dirtdigger/fleur_de_cali/img/120x3.jpg

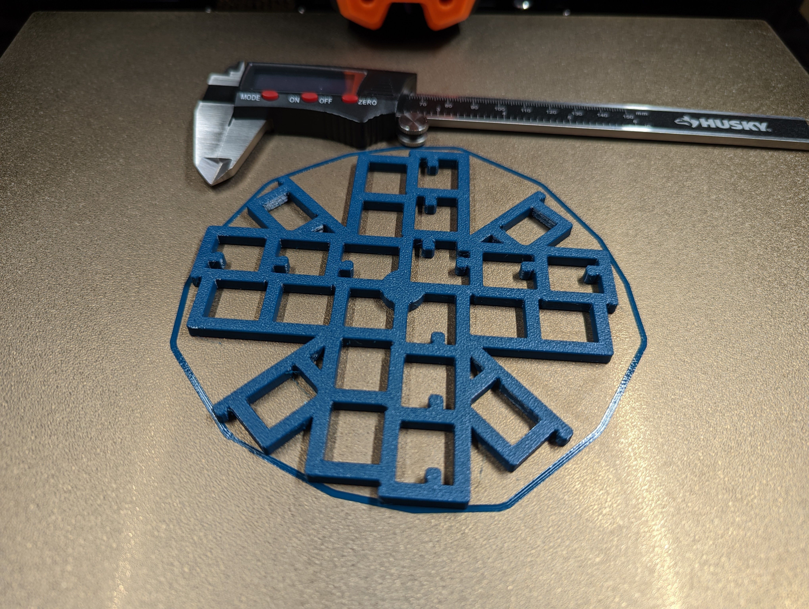
img/120x3.jpg
