dirtdigger/fleur_de_cali/img/120_D1.png

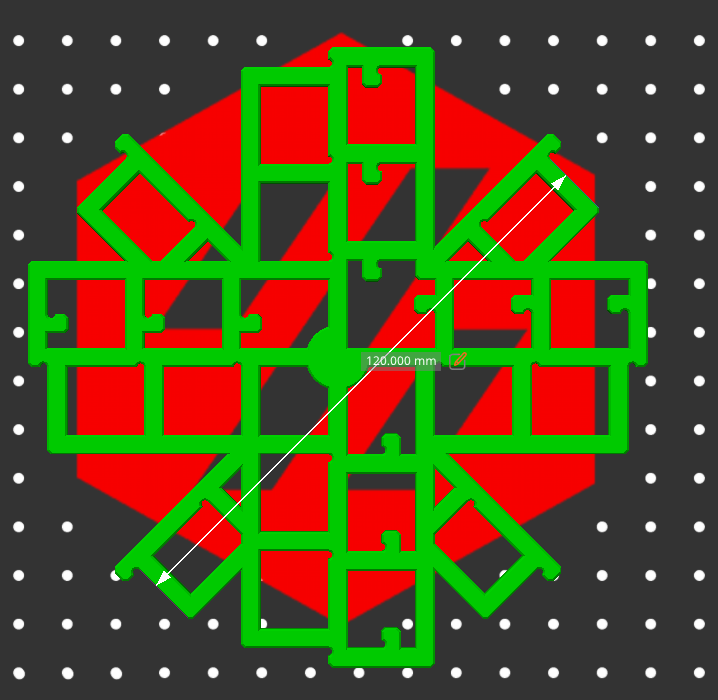
img/120_D1.png
