dirtdigger/fleur_de_cali/img/120_d1.png

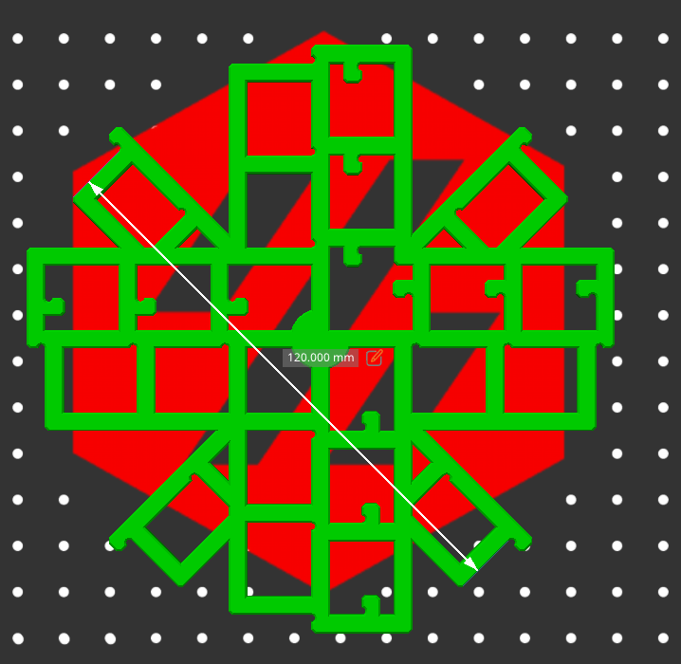
img/120_d1.png
