dirtdigger/fleur_de_cali/step/calistar_180x4.step

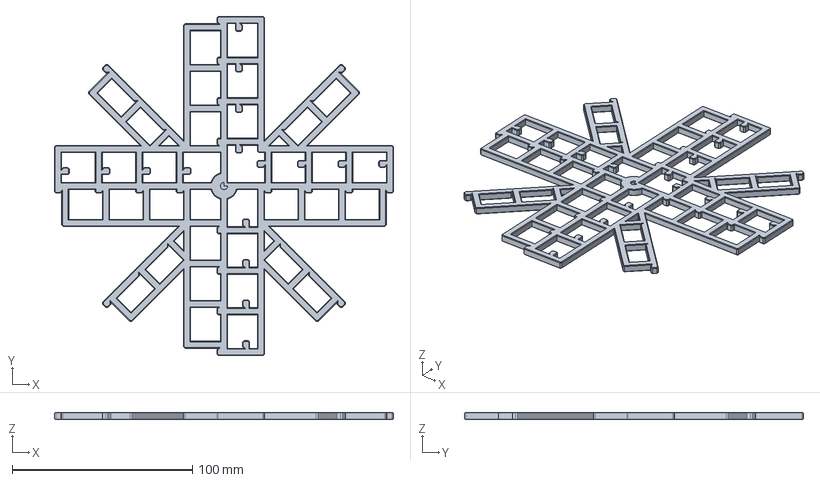
[picture p5: CAD file, 2024-03-23]
step/calistar_180x4.step
188.0 x 188.0 x 4.00 mm
