dirtdigger/fleur_de_cali/step/calistar_140x4.step

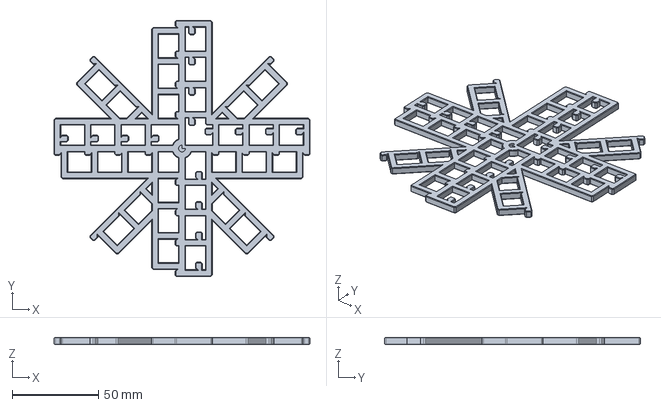
[picture p7: CAD file, 2024-03-23]
step/calistar_140x4.step
148.0 x 148.0 x 4.00 mm
