dirtdigger/fleur_de_cali/step/calistar_80x2.step

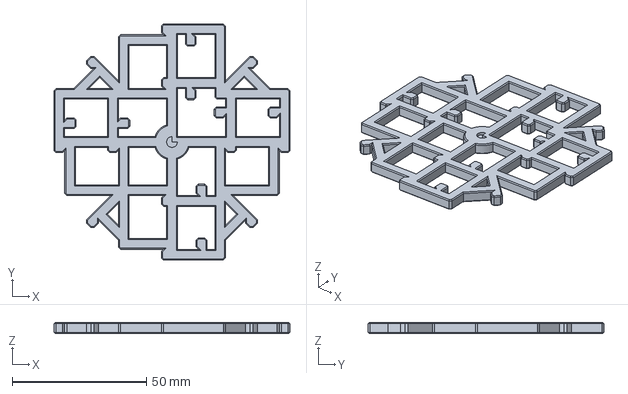
[picture p8: CAD file, 2024-03-23]
step/calistar_80x2.step
88.0 x 88.0 x 4.00 mm
