dirtdigger/fleur_de_cali/step/calistar_120x2.step

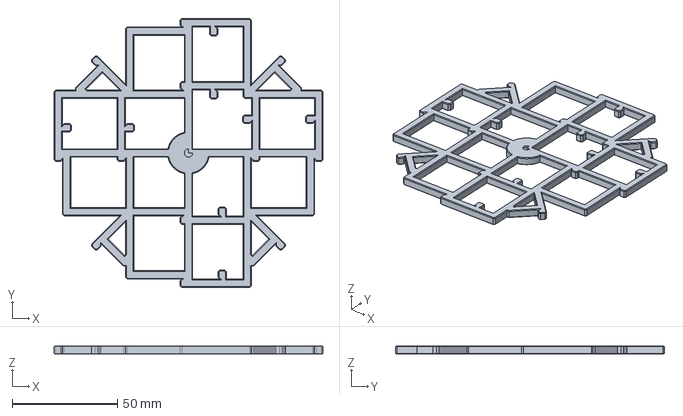
[picture p9: CAD file, 2024-03-23]
step/calistar_120x2.step
128.0 x 128.0 x 4.00 mm
