dirtdigger/fleur_de_cali/step/calistar_100x2.step

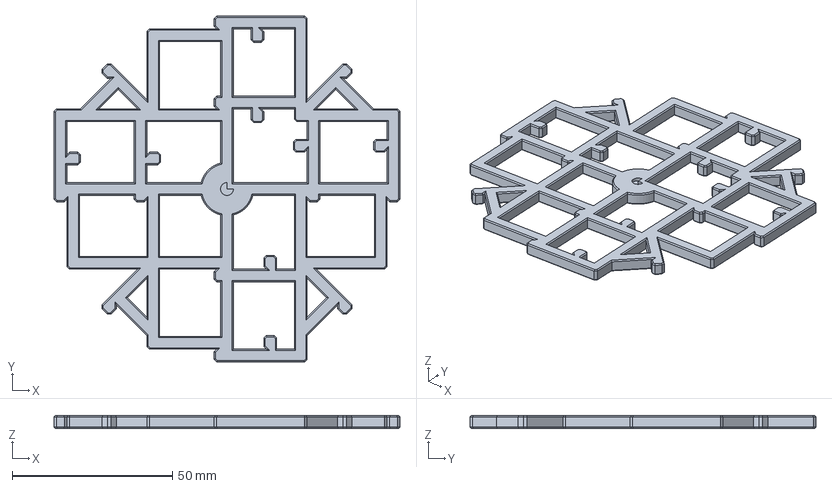
[picture p10: CAD file, 2024-03-23]
step/calistar_100x2.step
108.0 x 108.0 x 4.00 mm
