dirtdigger/fleur_de_cali/step/calistar_150x5.step

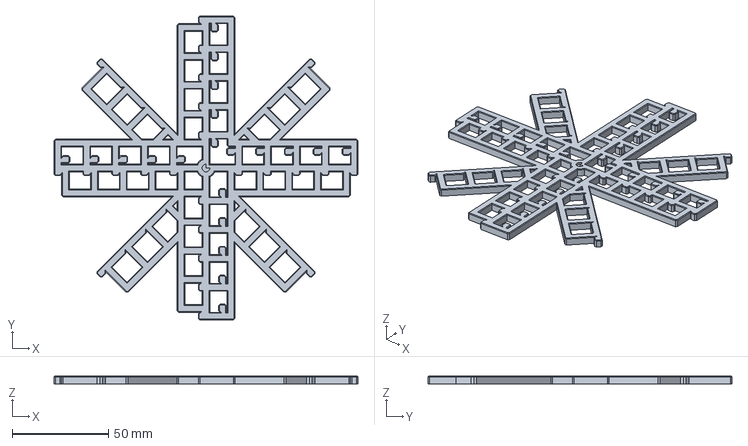
[picture p11: CAD file, 2024-03-23]
step/calistar_150x5.step
158.0 x 158.0 x 4.00 mm
