dirtdigger/fleur_de_cali/(list of files, cad)

Other CAD files:
stl/calistar_100x2.stl
stl/calistar_120x2.stl
stl/calistar_120x3.stl
stl/calistar_140x4.stl
stl/calistar_150x3.stl
stl/calistar_150x5.stl
stl/calistar_180x4.stl
stl/calistar_180x5.stl
stl/calistar_80x2.stl
