dirtdigger/fleur_de_cali/Parametric Skew Calibration.xlsx

Sheet: Intro
Before you start, fill out the information below
Number of measurement points | 3
Total width (cm) | 120
Scale | 1 | Did you do any additional scaling before printing the model? (Not recommended). If not, keep this as a 1
X steps/mm | 40 | Your printer's current X-steps (M503), or rotation_distance in Klipper printer.cfg
Y steps/mm | 40 | Your printer's current Y-steps (M503), or rotation_distance in Klipper printer.cfg
Caliper error (mm) | 0.01 | How precise your calipers are. Note: digital calipers, even though they read to the nearest 0.01mm, are often only actually accurate to 0.02mm
Use sample error | TRUE | Whether or not you want to use the measurements in the estimate of error, or just the caliper error you inputted above. You'll probably get smaller error estimates here, but they will likely be smaller than they actually are
Is your printer coreXY? | TRUE | Set TRUE for coreXY, otherwise set to FALSE

Sheet: Post-print worksheet
Tips for best results:
1. Allow the print to cool completely before measuring
2. Remove the print from the bed
Measure in this order:
 | 1. x-axis outside | (horizontal in picture)
 | 2. x-axis inside | (horizontal in picture)
 | 3. y-axis outside | (vertical in picture)
 | 4. y-axis inside | (vertical in picture)
 | 5. Diagonals | (Capital D first, then lowercase d)
Along each axis, measurements work from the outside in (see figure)
 |  | ⬐ | Hint: filter out ‘x’ values out of this column
 | Location | Nominal | Measurement 1 | Measurement 2 | Measurement 3 | Average
Outer X | 1 | 120.00
 | 2 | 80.00
 | 3 | 40.00
 |  | x
 |  | x
Inner X | 1 | 120.00
 | 2 | 80.00
 | 3 | 40.00
 |  | x
 |  | x
Outer Y | 1 | 120.00
 | 2 | 80.00
 | 3 | 40.00
 |  | x
 |  | x
Inner Y | 1 | 120.00
 | 2 | 80.00
 | 3 | 40.00
 |  | x
 |  | x
Diagonal (capital D) | 1 | 120.00
 | 2 | 80.00
 |  | x
 |  | x
diagonal (lowercase d) | 1 | 120.00
 | 2 | 80.00
 |  | x
 |  | x
Your measurement is within 0.5mm of expected input (does not mean your printer is calibrated!!)
Your measurement is more than 0.5mm and less than 1mm of the expected input. Please double check your measurement
Your measurement is more than 1mm away from expected input. Did you scale the model and forget to update the scale factor on intro sheet?
For best results, make sure for every outer measurement you have a corresponding inner measurement.

Sheet: Fixing your printer
Read me first!
Skew cannot be iteratively tuned. Therefore, if you have already attempted to correct your skew, you should remove the correction before trying again
If you're using a CoreXY printer, ensure you have "CoreXY" set to TRUE on the Intro sheet
Ensure your current x- and y-steps are up to date on the Intro sheet
Results
Dimensional correctness
 |  | Error | 1-sigma Error | Correction | Key
X-axis |  | #DIV/0! | 0.00000% | #DIV/0! | Your printer is calibrated to within one standard deviation. Hooray!
Y-axis |  | #DIV/0! | 0.00000% | #DIV/0! | Your printer is calibrated to within two standard deviations. Not bad!
Skew angle |  |  |  |  | Your printer is calibrated to within three standard deviations. You
 |  | Measured | 1-sigma Error | Correction |  | may still be able to do some adjustments
Angle of parallelogram |  | #DIV/0! | #DIV/0! |  | Your printer is not yet calibrated
Skew |  | #DIV/0! | #DIV/0! | #DIV/0!
Calibrating your printer
Klipper |  |  |  |  |  | Marlin
See the Klipper documentation for details. https://www.klipper3d.org/Skew_Correction.html?q= |  |  |  |  |  | In a console, paste the following:
For your printer, use |  |  |  |  |  |  | #DIV/0!
#DIV/0! |  |  |  |  |  | You should see "Recv. ok"
#DIV/0! |  |  |  |  |  | Then type M500 in your console to save the settings
#DIV/0!
Please read the Klipper documentation to understand what you are doing!
Your skew correction gcode is:
#DIV/0! |  |  |  |  |  | Skew compensation coming soon!
SKEW_PROFILE SAVE=my_skew_profile
To have Klipper calculate your skew, enter this into a console:
#DIV/0!
In your printer.cfg, adjust
rotation_distance: | #DIV/0! | in [stepper_x]
rotation_distance: | #DIV/0! | in [stepper_y]

Sheet: Helper
Just some math to do the skew calculation and error propagations
 | Measurement | Input Expected | Input Valid | Nominal | Sample mean | Sample stdev | Est. abs. error (mm) | Relative error | Dim. Gradient | sigma*Grad
Outer X | 1 | TRUE | FALSE | 0.00 |  | 0.00 | 0.003333333333
 | 2 | TRUE | FALSE | 0.00 |  | 0.00 | 0.003333333333
 | 3 | TRUE | FALSE | 0.00 |  | 0.00 | 0.003333333333
 |  | FALSE | FALSE | 0.00
 |  | FALSE | FALSE | 0.00
Inner X | 1 | TRUE | FALSE | 0.00 |  | 0.00 | 0.003333333333
 | 2 | TRUE | FALSE | 0.00 |  | 0.00 | 0.003333333333
 | 3 | TRUE | FALSE | 0.00 |  | 0.00 | 0.003333333333
 |  | FALSE | FALSE | 0.00
 |  | FALSE | FALSE | 0.00
Outer Y | 1 | TRUE | FALSE | 0.00 |  | 0.00 | 0.003333333333
 | 2 | TRUE | FALSE | 0.00 |  | 0.00 | 0.003333333333
 | 3 | TRUE | FALSE | 0.00 |  | 0.00 | 0.003333333333
 |  | FALSE | FALSE | 0.00
 |  | FALSE | FALSE | 0.00
Inner Y | 1 | TRUE | FALSE | 0.00 |  | 0.00 | 0.003333333333
 | 2 | TRUE | FALSE | 0.00 |  | 0.00 | 0.003333333333
 | 3 | TRUE | FALSE | 0.00 |  | 0.00 | 0.003333333333
 |  | FALSE | FALSE | 0.00
 |  | FALSE | FALSE | 0.00
Diagonal (D) | 1 | TRUE | FALSE | 0.00 |  | 0.00 | 0.003333333333
 | 2 | TRUE | FALSE | 0.00 |  | 0.00 | 0.003333333333
 |  | FALSE | FALSE | 0.00
 |  | FALSE | FALSE | 0.00
diagonal (d) | 1 | TRUE | FALSE | 0.00 |  | 0.00 | 0.003333333333
 | 2 | TRUE | FALSE | 0.00 |  | 0.00 | 0.003333333333
 |  | FALSE | FALSE | 0.00
 |  | FALSE | FALSE | 0.00
 | Skew calculation |  | Gradients and variances for skew error
 | Value | Accuracy | sigma | Gradient | sigma*Grad
p | #DIV/0! | #DIV/0! | #DIV/0! | #DIV/0! | #DIV/0!
q | #DIV/0! | #DIV/0! | #DIV/0! | #DIV/0! | #DIV/0!
a | #DIV/0! | #DIV/0! | #DIV/0! | #DIV/0! | #DIV/0!
b | #DIV/0! |  | #DIV/0! | #DIV/0! | #DIV/0!
cos(angle) | #DIV/0!
angle | #DIV/0!
skew | #DIV/0! |  | Dimensionality | Percentage | Cartesian steps | CoreXY steps
skew standard deviation | #DIV/0! |  | X-axis | #DIV/0! | #DIV/0! | #DIV/0!
 |  |  | Y-axis | #DIV/0! | #DIV/0! | #DIV/0!
Number of valid measurements
Outer X | 0
Inner X | 0
Outer Y | 0
Inner Y | 0
Diagonal (D) | 0
diagonal (d) | 0
