dirtdigger/fleur_de_cali/(threads)

Thread 2 (2024-03-17):

Some ideas to enchance the accuracy

VooDisss, 2024-03-17:
Idea 1:
Make the groove deeper:
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
Idea2:
Round the skew adjustment values to either 3 or 4 instead of 2 digits decimal:
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
Idea3:
It would be awesome if you released the version to calibrate XZ and YZ axis also! Something like this tool - https://www.printables.com/en/model/70792-easy-3-axis-skew-calibration-tower-with-spreadshee .
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
Idea4:
Implement extrusion ratio calculation by using some calculations from this print: https://www.thingiverse.com/thing:1622868/comments
But I think this only would work if using 2 perimeters in print settings and no infill (cause infill can affect the accuracy as far as i understand), when printing at 0.8mm line width like I do with 0.4mm nozzle PLA filament currently. This link i showed made prints dimensionally accurate only when I was severely under-extruding, which means the first step should be this calibration, and then only that linked one (MAYBE)... But what if they would be combined into one? that would be great...
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

Thanks for this tool, I will test it further to see if its real deal... I have put weeks into calibrating my ender 3 and learned a lot of stuff, this tool you made seems one of the best methods yet I tried!

dirtdigger, 2024-03-17:
Thanks for the suggestions. Some pieces of feedback:

1. The purpose of those grooves is to avoid any rounding of the corner in such a way that the calipers aren't flush against the contact point. You can increase the variable "pa" at the top of the script to your liking to adjust this. Increasing it should do what you're asking. Does that scratch the itch, or am I not quite understanding the suggestion?
2. Easy enough to do, but honestly I doubt it will make much of a difference. 2 decimals is on the level of error of measurement error of most calipers. Perhaps what I'll do is to add more digits if the calculated standard deviation is less than 0.01.
3. I'll think about this a bit. Although the math should be the same, seems like getting stuff to mesh well to the point where you can still make the necessary measurements might be rather complex. I could see the xz geometry getting in the way of your calipers when you're measuring the yz geometry, and vice-versa. At the very least, a xz version with a pedestal to avoid elephant foot should be possible so you could calibrate each pair of axes one-at-a-time.
4. I have thought that flow/extrusion calibration or shrinkage compensation would be a fantastic addition to this. I think that flow rate compensation can likely be done by comparing the inner/outer measurements. Shrinkage can probably be fixed by a linear fit of the measurement points. It'd be nice if I had some additional data besides from my own two printers for testing. Would you mind sharing your measurements to help out with that?

Anyway, let me know if the pa variable is what you're looking for in 1 :-)

VooDisss, 2024-03-20:
Hi, sorry for a bit of a delay - my printer got broken heatsink and it was time to research and buy all the things needed to upgrade it on a budget (and resist not going ballistic with upgrades at it).
1, I understood, next time I try and succeed at launching calistar.py - i will check out "pa" variable.
4. I could help you with simple testing, once i upgrade and fix my ender 3 pro. You can find me on TG @emeraldas if need be.

VooDisss, 2024-03-22:
5. Add this line into calibration worksheet:
`="SET_SKEW XY= "&ROUND(Helper!B36,4)&","&ROUND(Helper!B37,4)&","&ROUND(Helper!B38,4)`

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

VooDisss, 2024-03-22:
1. Please instead of using a circle which reacts to "pa" parameter - make another figure or make the circle start at some other place instead, because any setting of "pa" harms accuracy - funamentally because it STARTS very near the place one should measure. The places where measurements occur should not have some curves nearby, cause they affect the measurements...

Please fix this, it's important I think, thanks.

dirtdigger, 2024-03-23:
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

Working right now on including this in the spreadsheet.

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

I'm not sure I follow the objection. The circle is tangent to the measurement surface, and the curvature is all on the interior, away from where the calipers are.

But, this may be overcome by events in the next version. I'm planning on moving toward a design that has a chamfer there instead.

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

Let me know if that doesn't address your concern.

VooDisss, 2024-03-23:
Yeah, chamfer would be way better than that circle!

Thanks for including that line into spreadsheet! i think its not possible to make one-liner to set xy skew AND save it to default skew profile...
It would be good if you added save xy skew profile command, because usually people forget and have to google it then all the time instead... (while they could copy-paste)

VooDisss, 2024-03-23:
7. Calistar.py should take layer width into account, so there would not be unnecessary infills.

8. Calistar.py should have first bottom layer elephant foot compensation, although it writes in the script it has that functionality - i don't see it being true, it just makes chamfer on the top layers. One can use slicer elephant foot compensation you would say - but then the notches become not a single line, but break into small pieces (not a continous line).
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

9. I wonder - are the maths behind calistar really so rather simple? I guessed it would involve more calculations, because only you released a version comparable (maybe soon even better!) than califlower (i did not try it).

VooDisss, 2024-03-23:
6.1 Regarding caliper stops: It would be nice to have a setting to disable generating them. This way if one has pretty straight arms and eye - he does not need to rely on 3d printed help aligning calipers in a perpendicular way. Keep in mind that our eyes are very good at seeing things align. If that new chamfer (instead of radius) feature affects accuracy - I would say make it be able to turn off.

VooDisss, 2024-03-23:
12. Probably won't happen, but still throwing out there: use dynamic skew correction with klipper, where each layer has a different skew correction value set and loaded whilst printing. This could allow to find the ideal value in just one single print.

I think this would need some macro generated by excel to be copy-pasted into klipper printer.cfg and executed at every layer change using slicer "onlayerchange" gcode section.

This would require some math's way beyond me... But could be revolutionary if executed right, I think...

dirtdigger, 2024-03-23:
Thanks for catching the bottom chamfer not being generated, this is fixed in the latest commit (as has been the switch to chamfers).

Infills can be fixed in slicer settings, either set perimeters to be higher or infill percentage = 0.

To answer your question about the math, it really is very simple, see [here for example.](https://www.geeksforgeeks.org/length-of-diagonal-of-a-parallelogram-using-adjacent-sides-and-angle-between-them/)

The caliper stops are an important part of the print. If pressure advance/linear advance is not configured, corners become rounded. If this is the case, the rounded corners will push the calipers outward and cause the dimensions to be over-estimated. By adding the stop and cutting out the notch (either circular or through a chamfer), that moves the corner to a point where it doesn't in contact with the calipers.

Not really sure what you mean by an add/clear button, or even how to go about doing that in Excel. At that point, Excel isn't the right tool to be using. The easiest thing to do is to simply save a copy of the spreadsheet every time.

kitchung, 2024-04-07:
Not necessarily accuracy but for ease of use and to prevent measuring wrong axis that can lead to inaccurate results is to have printed labels for the measuring points!

dirtdigger, 2024-04-10:
> Not necessarily accuracy but for ease of use and to prevent measuring wrong axis that can lead to inaccurate results is to have printed labels for the measuring points!

I had that at one point, but I had two issues:
1. I had to point CadQuery directly to a font file in order to get it to work correctly, and what fonts are installed may vary from operating system to operating system. So I'd have to include a font file in the repo if folks wanted to re-generate the script with it enabled, or have users hunt down a path to the font they want to use. Kind of messy.
2. The font had to be small (<4 mm height total, since that's the default thickness) and (in my opinion) looked kind of crummy. Here's how it looked on an older iteration:

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

I was intending the center of the print to help out with orienting the print (see [here](https://github.com/dirtdigger/fleur_de_cali/wiki/Measuring#orienting-the-print)), but maybe that's too subtle.

I don't know, what do you think? Too subtle, do you prefer the markings?

Jyers, 2025-05-13:
I wanted to throw my two cents in here as I just made some adjustments that seem to match one of the concerns raised here.

While the grooved do an okay job or avoiding rounding in the corners, I don't think they are adequate especially in cases such as when pressure advance and other optimizations are in play, as they can lead to small, but measurable extrusion issues _leading up to_ the corner, rather than just in the corner. To compensate I adopted a design more similar to califlower:

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

This should ensure all measurements are made in the middle of the straight segments without any nearby corners.

I unfortunately did not realize you had scripted this model (that's awesome btw!) So I made these modifications manually in CAD, but I might implement an updated python script if anyone is interested as that would make it expandable to the other sizes as well.

Thread 5 (2024-03-23):

Fundamental maths issue, it does not get progressively more accurate

VooDisss, 2024-03-23:
It does not get better, it needs some math's to take history into account i think, look at this, i printed 13 calistar already, and my printer is still not calibrated... :
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
It swings and over-compensates from one side to another and cannot calibrate, it need some math's based on how PID controllers work

My calistar.py settings:
`height    = 2
chamferSize = 0.4
thickness = 3.2
fullWidth = 145
numMeasPoints = 3
diagWidth = 25
pa = 0.6
fightElephantFoot = True`

slicer middle layer of the print:
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

VooDisss, 2024-03-23:
Keep in mind that I measure without removing the print from my PEI sheet, I just got it removed and it seems the measurements are way closer to nominal ones. Now i will try doing several prints with removing the print from the PEI sheet (after it cools down) and look if situation improves.

VooDisss, 2024-03-23:
After removing from the bed, the print got smaller substantially, these are the measurements:
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
I think that removing from the bed is fundamental, i will try printing with new settings now and get back to you

dirtdigger, 2024-03-23:
Skew cannot be iteratively fixed. Each time you print, the commands produced assume that there is no skew correction already being applied. If you've already got skew correction applied when you print the part, you'll likely make it worse.

Think of it like this: if your actual skew is 3 degrees, you correct for it once and reprint. It's probably still not perfect, so let's say post-calibration the residual skew is 0.2 degrees. The commands generated will adjust for that skew, but _from your printer's non-corrected_ state. But when  you enter that into your printer.cfg and reprint, and you're back to a 2.8 degree skew. So you adjust for that, re-print, get a small skew again, etc.

It's possible I could add a user-fillable current skew adjustment entry and adjust from that, but I'll need to work out what that looks like. In the meantime, I'll add some notes to the spreadsheet to prevent folks from thinking that iterative skew correction is possible.

If you're trying to calibrate a coreXY printer, your A/B motors are interlinked and need to be treated differently; given the fact that your x is calibrated by y is not, that likely explains the jumpiness you're seeing. The advice I've seen elsewhere is to average the two errors before applying. I'll add that note and an option to the spreadsheet.

dirtdigger, 2024-03-23:
> After removing from the bed, the print got smaller substantially, these are the measurements: ![image](https://private-user-images.githubusercontent.com/41582720/316256334-8a4cb3f5-c526-4501-9e35-5b28e5c4b7c2.png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) ![image](https://private-user-images.githubusercontent.com/41582720/316256347-340b1294-58e5-42ca-a224-7a26309410e0.png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) I think that removing from the bed is fundamental, i will try printing with new settings now and get back to you

That's probably due to material shrinkage. I never tried leaving the print on the bed while measuring.

VooDisss, 2024-03-23:
Yes, it would be very good if you wrote instruction on the best methodology to use this tool. Some recomendations like calibrating extrusion multiplier first according to this [tutorial](https://ellis3dp.com/Print-Tuning-Guide/articles/extrusion_multiplier.html). Once we get it to a good working and easy to use state, this would get way more popular i think...

VooDisss, 2024-03-23:
@dirtdigger Could you implement incremental skew correction by any chance? It would help, because with the current logic one has to print without skew correction, and if the correction is not within norms - he cannot adjust that incrementally anymore, just the XY steps and has to print another calistar without skew correction, then apply the new correction, so he can test the skew correction only every second print... right?

VooDisss, 2024-03-23:
Just printed on calistar without skew correction (just applied the XY steps calibration), then got the skew value and printed another one with the skew and XY calibration settings and bullseye! it was right on spot regarding the skew value!
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
Just gotta have that value not change and adjust XY steppers one more time

dirtdigger, 2024-03-23:
Nice! FYI, I added a coreXY switch to the latest spreadsheet, I recommend updating to it if you haven't already and are using coreXY as opposed to cartesian (it simply averages out the corrections).

I've got a plan to add iterative skew correction capability, expect that coming up.

VooDisss, 2024-03-24:
I figured that my ender 3 pro and other bed slingers have fundamental engineering trade-off sacrificing accuracy for budget... The belt carrier is of a poor design, also I noted from other klipper users that one should measure the X carriage movement only manually using calipers and not by measuring a print.

Assuming the esteps are calculated and X carriage components are of good quality (steppers/belt sprocket/X carriage) then one should apply only XY expansion coefficients to his print. Otherwise the accuracy on this ender 3 of mine largely depends where the printhead is (in the middle is the most accurate place, while on the left the Z height is most consistent due to no dual Z axis mod (yet).

This is said to be the proper way to route bedslinger belt:
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
I will have to try this trick.
@dirtdigger I suggest you read some of these links to maybe come up with another methodology to calibrate the printer, which would include measuring the X carriage physically for cheap ender 3 (or some other bedslinger with this flaw, there are tons of them) bedslingers. Just need a printable, to mount calipers on X extrusion and measure travel, only then continue adjustments...
The links:
https://klipper.discourse.group/t/correct-dimensional-accuracy/6093/9
https://klipper.discourse.group/t/correct-dimensional-accuracy/6093/10
https://klipper.discourse.group/t/correct-dimensional-accuracy/6093/7
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

This explains why my outer measurements were accurate, while the more i measure places on the calistar in the middle - the less accurate it gets - it's cause the X carriage movement is non-linear (maybe Y axis too, i dont know yet)

VooDisss, 2024-03-24:
I suggest going at the extreme and on bedslinger measuring in 10mm increments the X carriage movement and comparing the real vs virtual values (virtual 10mm, real might be more or less) and write it into excel, and here comes the spreadsheet - you could include this into the spreadsheet for establishing a good baseline on what approach should be used before and during calibration using calistar
Quote from [here](https://klipper.discourse.group/t/correct-dimensional-accuracy/6093/7)
"After all, the error might not be because of weird Al-extrusion imperfections or POM-wheel eccentricities or whatnot, but it could be because your belt or your belt gear is slightly too thick or thin, and thus cause a systematic error, and this should be compensated for exactly in the steps configuration.

But yes, you should first figure out if your error is indeed systematic, by measuring at multiple points. If you get that X 0-20 is off one way and X 20-40 is off the other way, or if Y 0-150 is off by one value at one point, but later it’s off by a completely different value, then the error is indeed in something more or less unpredictable, so changing your steps config might not be helpful at all."

dirtdigger, 2024-03-24:
I can add a note about your quotation to the README.md, but I'll be honest, I'm not really interested in adding scope to the spreadsheet. The intention is a companion calculator to the stl that is generated by calistar.py.

What you've found is valuable for Enders, but unfortunately I don't own one in order to do testing. I can't tailor the calculator for each possible variation of 3d printer. If a specific printer model needs special treatment, that's better suited to come from the subcommunity that forms around that model.

dirtdigger, 2024-03-24:
Added notes to README.md (886a3b)

Closed 2024-03-24.

Thread 6 (2024-03-27):

Z skew missing

eafq78, 2024-03-27:
can you add the Z please?
It is very important for Z deviation on tall objects

dirtdigger, 2024-04-10:
@Voodiss suggested this in another issue. I'm open to the idea, but I think it'll take some careful planning to do right.

@Voodiss's suggestion was to base on this [model](https://www.printables.com/en/model/70792-easy-3-axis-skew-calibration-tower-with-spreadshee), but my issue with that model is that when measuring each axis, other axes will get in the way of the calipers. I think the "right" answer probably a mix of that model and [this one]https://www.thingiverse.com/thing:2972743).

Anyhow, I'll add it to my to do list. For now it's kind of low priority as I want to get other firmwares implemented, and iterative skew correction working.

eafq78, 2024-04-10:
Thanks, and you are right something in between will be better
I mod the last one here https://www.printables.com/model/822670-xyz-3-axis-skew-calibration-with-calculator
I used it in 3 printers with almost perfect results on the first try ( I print taller objects and this is a must)

Boerny41, 2024-12-27:
@eafq78 the link does no longer work. Any chance you still got the relevant files?

Thread 7 (2024-03-27):

Radioactive calistar is/seems missing here

ProBackup-nl, 2024-03-27:
The printables.com model downloads also has a radioactive shaped version.

That radioactive calistar variant, seems missing here.

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

dirtdigger, 2024-03-28:
This is in a separate branch currently [link](https://github.com/dirtdigger/fleur_de_cali/tree/radioactive_calistar)

Closed 2024-03-28.

Thread 8 (2024-04-18):

In Numbers the skew calculation fails

ProBackup-nl, 2024-04-18:
Tab "Helper", B36 shows an error in calculation exclamation sign.

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

dirtdigger, 2024-04-18:
Looks like you're using an older version of the spreadsheet (latest has five tabs). Can you try with the [current master version](https://github.com/dirtdigger/fleur_de_cali/blob/main/Parametric%20Skew%20Calibration.xlsx) and see if the problem persists?

Also, what spreadsheet editor are you using? I don't recognize it, so I probably haven't done any testing with it.

ProBackup-nl, 2024-04-19:
Even when summing D24:D27 manually, that results in 0, thus will result in a division by 0 in B37.
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

dirtdigger, 2024-04-19:
This might be a difference in how Apple Numbers works. The important thing is that sumproduct with booleans should treat the booleans as 0/1.

Can you do be a favor and test out a small spreadsheet like the one below in a fresh spreadsheet to confirm the behavior for me?

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

If that's the issue, I'll see if I can work out something that works in Numbers without breaking backward compatibility with Excel, Sheets, and LibreOffice.

dirtdigger, 2024-04-19:
Attached a potential fix in case this is the issue. (Please note this is a working copy that has iterative skew correction that's just in testing right now, so that part might not be working properly yet).

[Parametric Skew Calibration_numbers_fix.xlsx](https://github.com/dirtdigger/fleur_de_cali/files/15041276/Parametric.Skew.Calibration_numbers_fix.xlsx)

Thread 9 (2024-07-11):

Better indications of measurements points

brunetton, 2024-07-11:
Hi

Just discovered this open source version of the calibration flower, and I'm very happy to find it ! Thank you a lot !

Just printed it, and I realized that my steppers motors config has been completely lost after my last Marlin upgrade. Nothing in the printed part corresponds with the theoretical dimensions. And it took me some time to understand the measurements I had to do:

Where is x1 ? I thought it was the red line before I realized it wasn't

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

Same for interior x1

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

This is quite error prone IMHO

## Proposed solution

I took some time and done this schema, that IMHO is more clear:

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

Svg version if you want to edit it (I used [Inkscape](https://inkscape.org)): https://github.com/dirtdigger/fleur_de_cali/assets/86322/50affcdd-ab63-4a53-8015-34575f0b3553

brunetton, 2024-07-11:
PS: if you're interested I can search for a way to apply infill to the flower; fow now it's not possible (lines are not connected)

dirtdigger, 2024-09-05:
Hi brunetton,

Thanks for the suggestion. I agree that the markings could be clearer.

I will be working on a web-based calibration worksheet that will replace the spreadsheet going forward. Would it be OK if I use your graphic in that version of the calibration tools?

brunetton, 2024-09-05:
> I will be working on a web-based calibration worksheet that will replace the spreadsheet going forward. Would it be OK if I use your graphic in that version of the calibration tools?

Of course ! But as I said before the lines are not connected (I didn't found a proper way to render a top view of the 3D object) so the interior of the flower cannot be colored :s this is not good for readability but maybe you'll find a workaround.

dirtdigger, 2024-10-11:
I modified your suggestions to include 2, 3, 4, and 5 variants, see e.g. [here](https://github.com/dirtdigger/fleur_de_cali/blob/main/worksheet/docs/img/meas_pts_2.svg). These are now included in the latest browser-based worksheet, which I've uploaded to Printables as calistar_browser.zip

I haven't colored in the interior of the printed part, but think this might be a minor issue. What are your thoughts?

Thread 11 (2024-10-08):

Printing anomaly

boromyr, 2024-10-08:
Hi, I printed the 150x5 model, but there is an issue with the measurements:
for the diagonals, D1 is greater than d1, while the difference is reversed for D2, D3, etc., and for the internal diagonals d2 is greater than D3 and so on;
for the dimensions X and Y the same thing happens, X1 is smaller than Y1, but X2 and subsequent ones are greater than Y2, Y3, etc.
Based on other prints, the correct values are the external ones, D1 d1 X1 Y1, while the internal ones are inconsistent with past prints.
This behavior shouldn't be normal, I tried printing the file twice with the same result.
What could be causing this anomaly?

dirtdigger, 2024-10-11:
Hi boromyr,

It's hard to say for sure. It could be something mechanical, perhaps measuring the incorrect locations, print material interior shrinkage, ...

Couple of suggestions to try:
1. Can you try with a different model, e.g. 150x3, to see if the problem persists?
2. It could be that because the X2, X3, X4, X5 are interior (in the sense of they are not on the outermost perimeter of the print), this is related to interior horizontal expansion. Here's a post that may help on Prusa's forums [link](https://forum.prusa3d.com/forum/original-prusa-i3-mk3s-mk3-print-tips-archive/hole-diameter-size/#post-41119) - they suggest printing perimeters first. Or, perhaps look into horizontal hole expansion in Cura.
3. Can you confirm the measurement locations? Here's an updated map of the measurement locations that is more precise as to where you should be measuring compared to what's currently in the spreadsheet.
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
4. Can you provide detail as to the kind of printer? Creality printers (and perhaps others) have a known non-linearity which could account for this.
5. What material are you using?

boromyr, 2024-10-11:
I am printing in PLA with OrcaSlicer, Ender 3V3 Plus, which is a core xz, is one of the latest while the dimensional problem was about the first ender 3.
I disabled the hole expansion in the second print and any type of dimensional modification, printing the outer perimeters first.
I will try with another model, maybe a smaller one to see if there are any changes.
[calistar_150x5.3mf.txt](https://github.com/user-attachments/files/17342555/calistar_150x5.3mf.txt)

Here are the results, the last box is the difference with the theoretical one, as you can see all the internal measurements are very consistent with each other, but not with the external ones. If it were a problem of mechanical or systematic error, it should be constant in all directions.
Could the shrinkage of the internal filling affect it, since it is not very isotropic in terms of shrinkage direction?
<html xmlns:v="urn:schemas-microsoft-com:vml"
xmlns:o="urn:schemas-microsoft-com:office:office"
xmlns:x="urn:schemas-microsoft-com:office:excel"
xmlns="http://www.w3.org/TR/REC-html40">

<head>

<meta name=ProgId content=Excel.Sheet>
<meta name=Generator content="Microsoft Excel 15">
<link id=Main-File rel=Main-File href="file:///T:/LOCALT~1/msohtmlclip1/01/clip.htm">
<link rel=File-List href="file:///T:/LOCALT~1/msohtmlclip1/01/clip_filelist.xml">
<style>
<!--table
	{mso-displayed-decimal-separator:"\,";
	mso-displayed-thousand-separator:"\.";}
@page
	{margin:.98in .75in .98in .75in;
	mso-header-margin:0in;
	mso-footer-margin:0in;}
tr
	{mso-height-source:auto;}
col
	{mso-width-source:auto;}
br
	{mso-data-placement:same-cell;}
td
	{padding-top:1px;
	padding-right:1px;
	padding-left:1px;
	mso-ignore:padding;
	color:black;
	font-size:10.0pt;
	font-weight:400;
	font-style:normal;
	text-decoration:none;
	font-family:Arial;
	mso-generic-font-family:auto;
	mso-font-charset:0;
	mso-number-format:General;
	text-align:general;
	vertical-align:bottom;
	border:none;
	mso-background-source:auto;
	mso-pattern:auto;
	mso-protection:locked visible;
	white-space:nowrap;
	mso-rotate:0;}
.xl65
	{color:windowtext;
	font-size:11.0pt;
	font-family:Arial, sans-serif;
	mso-font-charset:0;}
.xl66
	{color:windowtext;
	font-family:Arial, sans-serif;
	mso-font-charset:0;}
.xl67
	{color:windowtext;
	font-size:11.0pt;
	font-family:Arial, sans-serif;
	mso-font-charset:0;
	border-top:.5pt solid black;
	border-right:none;
	border-bottom:none;
	border-left:.5pt solid black;}
.xl68
	{color:windowtext;
	font-size:11.0pt;
	font-family:Arial, sans-serif;
	mso-font-charset:0;
	border-top:.5pt solid black;
	border-right:none;
	border-bottom:none;
	border-left:none;}
.xl69
	{color:windowtext;
	font-size:11.0pt;
	font-family:Arial, sans-serif;
	mso-font-charset:0;
	border-top:none;
	border-right:none;
	border-bottom:none;
	border-left:.5pt solid black;}
.xl70
	{color:windowtext;
	font-size:11.0pt;
	font-family:Arial, sans-serif;
	mso-font-charset:0;
	mso-number-format:Standard;}
.xl71
	{color:windowtext;
	font-size:11.0pt;
	font-family:Arial, sans-serif;
	mso-font-charset:0;
	mso-number-format:Standard;
	border-top:none;
	border-right:.5pt solid black;
	border-bottom:none;
	border-left:none;}
.xl72
	{color:windowtext;
	font-size:11.0pt;
	font-family:Arial, sans-serif;
	mso-font-charset:0;
	border-top:none;
	border-right:none;
	border-bottom:.5pt solid black;
	border-left:.5pt solid black;}
.xl73
	{color:windowtext;
	font-size:11.0pt;
	font-family:Arial, sans-serif;
	mso-font-charset:0;
	mso-number-format:Standard;
	border-top:none;
	border-right:none;
	border-bottom:.5pt solid black;
	border-left:none;}
.xl74
	{color:windowtext;
	font-size:11.0pt;
	font-family:Arial, sans-serif;
	mso-font-charset:0;
	mso-number-format:Standard;
	border-top:none;
	border-right:.5pt solid black;
	border-bottom:.5pt solid black;
	border-left:none;}
.xl75
	{color:windowtext;
	font-size:11.0pt;
	font-family:Arial, sans-serif;
	mso-font-charset:0;
	mso-number-format:Standard;
	border-top:.5pt solid black;
	border-right:none;
	border-bottom:none;
	border-left:.5pt solid black;}
.xl76
	{color:windowtext;
	font-size:11.0pt;
	font-family:Arial, sans-serif;
	mso-font-charset:0;
	mso-number-format:Standard;
	border-top:none;
	border-right:none;
	border-bottom:none;
	border-left:.5pt solid black;}
.xl77
	{color:windowtext;
	font-size:11.0pt;
	font-family:Arial, sans-serif;
	mso-font-charset:0;
	border-top:none;
	border-right:none;
	border-bottom:.5pt solid black;
	border-left:none;}
.xl78
	{color:windowtext;
	font-size:11.0pt;
	font-family:Arial, sans-serif;
	mso-font-charset:0;
	mso-number-format:Standard;
	text-align:right;
	border-top:.5pt solid black;
	border-right:none;
	border-bottom:none;
	border-left:none;}
.xl79
	{color:windowtext;
	font-size:11.0pt;
	font-family:Arial, sans-serif;
	mso-font-charset:0;
	mso-number-format:Standard;
	text-align:right;}
.xl80
	{color:windowtext;
	font-size:11.0pt;
	font-family:Arial, sans-serif;
	mso-font-charset:0;
	mso-number-format:Fixed;
	border-top:none;
	border-right:.5pt solid black;
	border-bottom:none;
	border-left:.5pt solid black;}
.xl81
	{color:windowtext;
	font-size:11.0pt;
	font-family:Arial, sans-serif;
	mso-font-charset:0;
	mso-number-format:Standard;
	text-align:right;
	border-top:none;
	border-right:none;
	border-bottom:.5pt solid black;
	border-left:none;}
.xl82
	{color:windowtext;
	font-size:11.0pt;
	font-family:Arial, sans-serif;
	mso-font-charset:0;
	mso-number-format:Fixed;
	border-top:.5pt solid black;
	border-right:.5pt solid black;
	border-bottom:none;
	border-left:none;}
.xl83
	{color:windowtext;
	font-size:11.0pt;
	font-family:Arial, sans-serif;
	mso-font-charset:0;
	mso-number-format:Fixed;
	border-top:none;
	border-right:.5pt solid black;
	border-bottom:none;
	border-left:none;}
.xl84
	{color:windowtext;
	font-size:11.0pt;
	font-family:Arial, sans-serif;
	mso-font-charset:0;
	mso-number-format:Fixed;
	border-top:none;
	border-right:.5pt solid black;
	border-bottom:.5pt solid black;
	border-left:none;}
.xl85
	{color:windowtext;
	font-size:11.0pt;
	font-family:Arial, sans-serif;
	mso-font-charset:0;
	mso-number-format:Standard;
	border-top:.5pt solid black;
	border-right:none;
	border-bottom:none;
	border-left:none;}
.xl86
	{color:windowtext;
	font-size:11.0pt;
	font-family:Arial, sans-serif;
	mso-font-charset:0;
	mso-number-format:Standard;
	border-top:.5pt solid black;
	border-right:.5pt solid black;
	border-bottom:none;
	border-left:none;}
.xl87
	{color:windowtext;
	font-size:11.0pt;
	font-family:Arial, sans-serif;
	mso-font-charset:0;
	mso-number-format:Standard;
	border-top:none;
	border-right:none;
	border-bottom:.5pt solid black;
	border-left:.5pt solid black;}
.xl88
	{color:windowtext;
	font-size:12.0pt;
	font-family:Arial, sans-serif;
	mso-font-charset:0;}
.xl89
	{color:windowtext;
	font-size:12.0pt;
	font-family:Arial, sans-serif;
	mso-font-charset:0;
	mso-number-format:Standard;}
-->
</style>
</head>

<body link="#1155CC" vlink="#1155CC">

Diagonal   (capital D) | 1 | 150,00 | 149,80 | 149,77 |   | 149,79 | -0,21
-- | -- | -- | -- | -- | -- | -- | --
  | 2 | 120,00 | 119,73 | 119,7 |   | 119,72 | -0,28
  | 3 | 90,00 | 89,72 | 89,73 |   | 89,73 | -0,28
  | 4 | 60,00 | 59,80 | 59,78 |   | 59,79 | -0,21
diagonal (lowercase d) | 1 | 150,00 | 149,74 | 149,73 |   | 149,74 | -0,26
  | 2 | 120,00 | 119,96 | 119,98 |   | 119,97 | -0,03
  | 3 | 90,00 | 89,92 | 89,97 |   | 89,95 | -0,06
  | 4 | 60,00 | 59,97 |   |   | 59,97 | -0,03

</body>

</html>

dirtdigger, 2024-10-13:
Thanks for the update, bormyr. Let me know how the 120x2 works out with Prusaslicer.

I'm not super familiar with the Ender 3v3. I brought up mechanical problems not poking at your printer in particular. More, it was me wondering if there is something specific about the printer style that causes warping of sorts near the boundaries of the bed.

boromyr, 2024-10-28:
I also noticed that in the web version it is possible to iterate the calculation of the inclination, but not in the Excel sheet, I wanted to ask you how I can iterate the calculation in Excel, since I have not found any way to iterate the inclination calculation, I would be grateful to you.

Thread 12 (2024-11-04):

Elephant’s Foot Effect Causes Measurement Inaccuracies with Calipers

Zulu-Zap, 2024-11-04:
Problem:
I am encountering an issue with the calibration califlower where an elephant's foot effect—caused by excess material spreading at the base of the print—leads to a slight protrusion. This makes it difficult to get accurate measurements using calipers as the first layer protrudes beyond the intended dimension.

Potential Solutions:
Modify the calibration califlower design to include a slight chamfer at the bottom edge. This chamfer would help reduce the elephant’s foot effect by limiting the excess material spread at the base, ensuring more accurate measurements with calipers. It has already been applied on the top surface.

Zulu-Zap, 2024-11-04:
ok I reviewed your califlower, id does have chamfers. My bad

Closed 2024-11-04.

Thread 13 (2024-11-07):

"Current shrinkage setting" ignored in the "Results Dimensionality" sheet of the worksheet

onurfiliz, 2024-11-07:
First off thank you for this great tool.

In the per-filament shrinkage compensation section of the "Results Dimensionality" sheet, the "current shrinkage setting" value in cell B22 does not seem to have any effect. Doing a "Find" in the whole worksheet does not turn up any references, and the value calculated in B24 does not change when I modify B22.

Should the formula for B24 instead read `=B22/100/Helper!$G$43` instead?

Thanks.

m10d, 2025-03-04:
I noticed the same thing.  Syntax for your proposed fix specifically would be `=B22/100/$Helper.$G$43` at least on my system.

In the future, I will probably just zero out shrinkage comp for a new filament, rather than using a best-guess.  The below is very simple math, but also easy to make mistakes with lots of very similar scale numbers.   I have a feeling slicers represent shrinkage differently.

In excruciating detail for someone else finding this:

- cell `$B$24` (in current cali's xlxs on master) is the `Your adjusted shrinkage` value .   Note the cell is a float; it's _formatted_ as a percentage
- But PrusaSlicer filament `Shrinkage compensation` is inverted (it means "how much did your part shrink" NOT scale_factor.  And it is expressed as that percent `modulo 100`.
    - Eg enter into PrusaSlicer the result of `(1 - $B$24)*100 % 100` (C code) or `=mod( (1 - $B$24) * 100, 100)` in (libreoffice)
    > Prusaslicer help text:  "if you measure 99mm on a 100mm part, enter `1`"
- So _with_ this bug in the XLS, say the XLS  displays an "adjusted shrinkage" of `99.8%`  (eg cell `$B$24`; actual value is `0.998`)
    - if you printed with **NO** (zero) shrink, in PrusaSlicer you would simply input a `0.2`
    - but if you printed with say `0.4` in prusaslicer:
        - ie your **previous** calibration showed actual size 99.6% of desired size (the XLS' shrinkage factor), you told PrusaSlicer `0.4`, and PrusaSlicer (presumably) applied a scale factor of `1/.996= 1.004016` to the print
        - but your new print is `0.2%` smaller than expected meaning you want to scale "whatever you printed" by `1/.998 = 1.002004`
        - new net scaling factor is `1.004016 * 1.002004 = 1.006028`
        - your **new** _shrinkage_ value is `1/1.006028 = 0.994008` or `99.4008%`
        - and into PrusaSlicer you now enter a shrinkage of `(100 - 99.4008) % 100` = `0.5992`, that is to say your part shrunk 0.5992 percent versus no shrinkage.
        - Note that if this bug were fixed, then `B24` would hold the _value_ `99.6 / 100 / (1/0.998) = 0.994008` <-- exactly the "fix" formula at the top.

I really should have just written a code snip for that, would have been simpler to write :)

Thread 15 (2024-11-13):

Skew correction for Bambu

llitz, 2024-11-13:
I wanted to share the availability of skew correction for Bambu printers using an alternative method, that can perhaps be converted to calistar - there is more information on this thread:
https://forum.bambulab.com/t/skew-compensation-in-the-bambu-x1c-firmware/67661/492

There are a couple ways to work on the Skew correction, both are available throught the M1005 command:

1. Absolute correction
Provide I followed by the calculated number for the skew correction. This will be the new absolute value for correction, ignoring previous ones. For ex:

M1005 I-0.000836; Negative skew correction
M1005 I0.000836; Positive skew correction

2. Relative to the previous stored value correction
This is useful for iterative correction:

M1005 X119.22 Y118.57; this will add or subtract to the previous M1005 value
M500; Saves value

People with X1Plus firmware have been able to find a few other details:
M1005 I0; Resets calibration
M500; May be necessary to save calibration, some people had success without it
M1005 S1; enables skew calibration - Recommended not to use on the thread
M1005 S0; disables skew calibration - Recommended not to use on the thread

I have "M1005 In.nnn" version of the command on my start g-code, since it is absolute I can just leave it there.

There's a Google Spreadsheet in the thread - XY Skew Calculator and a STL used to calculate it - I am attaching both as reference to recalculate and convert anything, if needed.

This is the ascii diagram in one of the threads to support the measurements use this STL file

```

Y
 ^     B-------C
 |    /       /
 |   /       /
 |  A-------D
 +-------------->X
 XY SKEW FACTOR
```

[XY Skew Calculator.ods](https://github.com/user-attachments/files/17736195/XY.Skew.Calculator.ods)
[SquareCal_stl.zip](https://github.com/user-attachments/files/17736211/SquareCal_stl.zip)

matteopantano, 2024-12-15:
I would like to confirm that this is indeed true. I tried yesterday on my Bambu P1S and it works using the data from the spreadsheet. You can see the detailed approach with suggestion for G-code change from the post at: [forum.bambulab](https://forum.bambulab.com/t/skew-compensation-in-the-bambu-x1c-firmware/67661/516?u=user_2451066477).

Specifically, after completing all the measurements and inputting them into the Excel calibration file provided by fleur_de_cali (https://github.com/dirtdigger/fleur_de_cali/blob/main/Parametric%20Skew%20Calibration.xlsx), two crucial tabs are worth noting:

* ***Results Dimensionality***: This tab provides the shrink factor that should be added to the PLA profile.
* ***Results Skew***: This tab offers information about the parameters that should be used in the skew calculator (https://docs.google.com/spreadsheets/d/16GbZkK-qBmA-TsSA_l0wJZI_Dtr3uakR/edit?gid=1434627055#gid=1434627055).

Once you have the values from the XY Skew Calculator221, you need to modify the printer settings’ g-code. Specifically, I’ve made changes to the section called **Machine start G-code** at the beginning and end of the g-code. Some posts recommend avoiding homeing with the skew enabled and minimizing the accumulation of skew over power cycles.

Beginning:
```
; ensure we home without skew calibration
M1005 S0; disable skew
```

End:
```
; enable skew
M1005 S1; enable skew
M1005 I0; reset skew
M1005 I0.002272 ; add value from calculator221
M500 ; save to eprom
```

glstas, 2025-06-25:
Hey folks,

I came up with a formula that provides a more accurate result than the one used in the "XY Skew Calculator221".

Here's the formula:
-ASC((AC² - BD²) / (4 × AD × AB))
The result of this formula should be inserted after the M1005 I command.

The key difference is that Calculator221 uses an average value for AB, while my method requires measuring AB directly — which increases accuracy. So in total, you need to measure four values: both diagonals (AC and BD) and both sides (AD and AB).

You can find the Google Sheet here:
https://docs.google.com/spreadsheets/d/16GbZkK-qBmA-TsSA_l0wJZI_Dtr3uakR/edit?gid=1434627055#gid=1434627055

And here’s the exact formula you can plug into the sheet:
=-ASC((D15^2 - D16^2) / (4 * D17 * {YOUR AB}))

If anyone knows how to contact the original author of Calculator221, I’d appreciate a tip — I haven’t been able to find any info.

Cheers!

Thread 16 (2025-01-02):

Different rotational distance correction values between excel and web

colaigor, 2025-01-02:
I printed 180x5 star and im getting different correction results.
For reproduction, here are the average values:

179.86
144.05
108.00
72.03
36.04
179.90
143.95
107.89
71.92
35.96
179.66
143.83
107.83
71.92
35.97
179.70
143.80
107.77
71.90
35.94
179.70
143.73
107.79
71.89
179.92
143.96
108.02
(note, website is missing the field for d1 dimension, left blank in excel too)

By entering those results (cartesian) and leaving everything else default, im getting:

excel:
rotation_distance:	40.000	in [stepper_x]
rotation_distance:	40.000	in [stepper_y]

Your printer's corrected values are:
rotation_distance:	40.000	in [stepper_x]
rotation_distance:	39.920	in [stepper_y]

web:
[stepper_x]	40.000
[stepper_y]	40.000

Your printer's corrected values are as follows:
[stepper_x]: rotation_distance: 39.985
[stepper_y]: rotation_distance: 39.938

Skew excel:
Length AC = 179.685
Length BD = 179.96
Length AD = 127.276

Skew web:
AC	106.36050
BD	93.20646
AD	70.71068

nmedward, 2025-01-10:
I am seeing the same behavior. I am getting a different skew angle between the web and excel versions.

Aapenootjes, 2025-01-10:
Same for me, used a 150/5 calistar; the d4 input row is missing.

This is most likely what causes the other issues as well: I've filled the D4 row with zeroes and got results that are somewhat more in line with the excel sheet.

I think it might be an issue in javascript/calibration.js on row# 31:

`  for (let ii = 0; ii < 27; ii++)`

I changed that to:

`  for (let ii = 0; ii < 28; ii++)`

And the last row showed up for me.
I'm not even remotely experienced with coding so it might not be the proper solution. Also I've never made a pull-request myself so I'm kinda too afraid to do it...

patg84, 2025-01-20:
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

Even if this is fixed it still produces different values between the web and Excel versions. I opened a PR with a different fix for that issue.

Aapenootjes, 2025-01-20:
I've taken a bit of a look at the different Excel sheets. I think the XLSX in the zip file in the root is slightly older seems to be less complete, it does calculates measurement/absolute error differently. This mostly influences the Sigma values etc. but not the values used to calibrate the printer.

There do seem to be a few mistakes in the newer (root & printables) XLSX versions. For example: in the helper tab cells K22 & K23 are calculated inconsistently with the rest of the column and the amount of decimals shown is set too low in those cells. This affects the "1-sigma Error" value in the D7 cell on the "Results Dimensionality" tab.

However, the biggest issue I've found so far is in the calculations for the Klipper and Marlin fixes. The newer XLSX file is rounding at the wrong point in the calculation:

`=IF($B$45="CoreXY"; $B$43/ROUND(Helper!$G$43;3);$B$43/ROUND(Helper!$F$43;3))`
(cell B47, tab: Results Dimensionality)

It rounds down the value in cell G43 or F43 on the helper tab before dividing the default "rotation_distance" with this value. Instead it should round after dividing!

This should fix that:

`=IF($B$45="CoreXY"; ROUND($B$43/Helper!$G$43;3);ROUND($B$43/Helper!$F$43;3))`

The Marlin section suffers the same issue. Also note the Marlin section in the old XLSX file doesn't account for CoreXY printers.

`="M92 X"&ROUND(ALS($B$54="CoreXY"; $B$52*ROUND(Helper!$G$43;3);$B$52*ROUND(Helper!$F$43;3));3)&" Y"&ROUND(ALS($B$54="CoreXY"; $B$53*ROUND(Helper!$G$44;3);$B$53*ROUND(Helper!$F$44;3));3)`
(cell B56, tab: Results Dimensionality)

I changed that to:

`="M92 X"&ROUND(ALS($B$54="CoreXY"; $B$52*Helper!$G$43;$B$52*Helper!$F$43);3)&" Y"&ROUND(ALS($B$54="CoreXY"; $B$53*Helper!$G$44;$B$53*Helper!$F$44);3)`

With these changes I get mostly the same results across the newer XLSX and the web version except for the earlier mentioned calculations for measurement/absolute error (column H on the helper tab).

patg84, 2025-01-20:
Yep the Excel sheets are all over the map with errors. K22 and K23 are inconsistent with the rest of the column and on the zipped up xlsx there's an inconsistent formula in J23. Looks like it was never proofed.

How would you go about iteratively tuning for dimensionally accurate prints if none of these calibration tools allow you to tune that way?

Aapenootjes, 2025-01-22:
> How would you go about iteratively tuning for dimensionally accurate prints if none of these calibration tools allow you to tune that way?

The web version seems to work somewhat okay for the iterative process. On the Result Dimensionality tab of newer XLSX the adjusted shrinkage value doesn't take into account the filled in current shrinkage value. This can be fixed by updating the code for cell B24 to `=($B$22/100)/Helper!$G$43`, an IF statement to check if cell B22 has been filled out might be nicer though.

I've used it three times now, and I actually made a mistake on one by "fixing" my printer's dimensionality both in Klipper as well as in my slicer at the same time. I was tired...
Currently I've got skew within 0.007°, The X axis at -0.0005%, but the Y axis at +0.0547%.

Now with these numbers you'd expect a near perfect print in the X axis right? Unfortunately this is not the case but I might be at the limit of what this tool in its current state can provide me.
My latest 150mm print is somewhat undersized at the points further from the center and oversized at the points closer to the center, more so in the X then the Y axis. The Calistar calculations just averages this out for the adjustments.

In my situation there might be other influences on dimensionality at play beyond just the XY accuracy and the filament shrinkage. Some thoughts I had:
- Bed meshing. My Klipper printer is configured to fade to go from the measured bed mesh to flat over a number of layers. As far as I'm aware Klipper doesn't compensate flow or anything for the higher or lower layers resulting from this. I can imagine it can result in walls that are slightly over or undersized.
      - Calistar should perhaps be printed with bed mesh fade disabled. https://www.klipper3d.org/Bed_Mesh.html#mesh-fade
- Side cooling fan. My printer has a side cooling fan on one side only. I wonder if this influences the shrinking in a non-linear way across the part.
      - I should disable the side fan for this print.
 - Wall settings in slicer.
      - I should try the "precise walls" setting in Orca and check some other settings that might influence wall accuracy as well.

It's possible to do some more measurements on the Calistar model, there is more potential. As an example, on the 150x5 model one can measure a nominal 90mm distance between X1 & X5, X2 & X4, etc. Any deviations between those measurements could point to non-linearity in the gentry or through some other source like the points I mentioned above.

patg84, 2025-01-22:
> I've printed and used Calistar three times now, and I made a mistake once by "fixing" my printer's dimensionality both in Klipper as well as in my slicer at the same time. I was tired...

This just made me think of something. In the web version, under the heading "How to fix your printer's dimensionality" should we be using both the new Cura/Orca shrinkage values and the new Klipper rotational values or one or the other?

colaigor, 2025-01-22:
> > I've printed and used Calistar three times now, and I made a mistake once by "fixing" my printer's dimensionality both in Klipper as well as in my slicer at the same time. I was tired...
>
> This just made me think of something. In the web version, under the heading "How to fix your printer's dimensionality" should we be using both the new Cura/Orca shrinkage values and the new Klipper rotational values or one or the other?

only one, i was also banging my head over that untill i realized whats wrong. Had to print 8 calistars before i realized its not worth it in material price and bought califlower.

patg84, 2025-01-22:
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

Ah. That makes sense. I was wondering why it correct my skew issue but now cubes are lopsided. Longer Y values than X. Did you purchase the MK2? If you did which slicer and FW are you using?

Aapenootjes, 2025-01-22:
> > I've printed and used Calistar three times now, and I made a mistake once by "fixing" my printer's dimensionality both in Klipper as well as in my slicer at the same time. I was tired...
>
> This just made me think of something. In the web version, under the heading "How to fix your printer's dimensionality" should we be using both the new Cura/Orca shrinkage values and the new Klipper rotational values or one or the other?

I would only tune one of those for each iteration, it applies the calculated correction fully to each separate method, it's not split between them. Also, to revert the rotational distance setting in Klipper back to stock without fully losing the tune it applied you just do:
`new-shrinkage% = current-shrinkage% * (tuned-rot-dist \ default-rot-dist)`

On a CoreXY style printer it might be a bit tricky to tune X and Y separately using Klipper's rotational distance, it would automatically add skew complicating things. Probably why I haven't seen anyone recommend even trying this. On a Cartesian style printer I'd actually start with this method to equalize the X and Y axis.

On a CoreXY one should also start with equalising the belt tensions.

@colaigor I fully understand the sentiment. I might go that route in the near feature too, also to tune on the Z-axis without too much work. But I probably learn more myself by messing around a bit with this.

Thread 22 (2025-04-11):

Missing Delta Configuration

dookiejones, 2025-04-11:
Delta printers are not accounted for in the worksheet.
