dirtdigger/fleur_de_cali/(commit log)

2024-02-23 Add files via upload
    Initial commit since Printables has sold out.
    [Skew Calibration.xlsx, fleur_de_cali_4mm.stl, fleur_de_cali_8mm.stl]
2024-02-25 Add files via upload
    Added parametric designs.
    [fleur_de_cali_100x2.stl, fleur_de_cali_120x2.stl, fleur_de_cali_120x3.stl, fleur_de_cali_120x4.stl, fleur_de_cali_120x5.stl]
2024-03-05 Add additional sizes
    [calistar_100x2.step, calistar_100x2.stl, calistar_120x2.step, calistar_120x2.stl, calistar_140x4.step, calistar_140x4.stl, calistar_80x2.step, calistar_80x2.stl]
2024-03-05 Add files via upload
    Fixed a critical bug in generating the Klipper commands to correct skew.
    [Parametric Skew Calibration.xlsx]
2024-03-06 Add files via upload
    Bug fix where Excel doesn't get along with datatypes as well as Google Sheets or LibreOffice.
    [Parametric Skew Calibration.xlsx]
2024-03-09 Add files via upload
    Updated stls and steps to include orientation helpers.
    [calistar_100x2.step, calistar_100x2.stl, calistar_120x2.step, calistar_120x2.stl, calistar_120x3.step, calistar_120x3.stl, calistar_120x4.stl, calistar_140x4.step]
2024-03-17 Wrap show_object in a try/except
    In case one tries to run from the command line or other editor.
2024-03-22 Added skew compensation line directly to spreadsheet
    [Parametric Skew Calibration.xlsx]
2024-03-22 Remove data that was in spreadsheet
    [Parametric Skew Calibration.xlsx]
2024-03-23 Add suggestions from VooDisss to spreadsheet
    [Parametric Skew Calibration.xlsx]
2024-03-23 Spreadsheet updates and caveats.
    1. Add CoreXY option (averages x/y-step adjustments)
    2. Warning about iterative skew correction
    [Parametric Skew Calibration.xlsx]
2024-03-23 Shifted to chamfers for pressure advance correction.
    General code cleanup
2024-03-23 Cleanup stl directory
    [calistar_100x2.step, calistar_120x2.step, calistar_120x4.stl, calistar_140x4.step, calistar_80x2.step]
2024-03-23 Update stl folder with latest versions
    [calistar_100x2.stl, calistar_120x2.stl, calistar_120x3.stl, calistar_140x4.stl, calistar_150x3.stl, calistar_150x5.stl, calistar_180x4.stl, calistar_180x5.stl]
2024-03-23 Clean up step folder
    [calistar_120x4.step]
2024-03-23 Update step files
    [calistar_100x2.step, calistar_120x2.step, calistar_120x3.step, calistar_140x4.step, calistar_150x3.step, calistar_150x5.step, calistar_180x4.step, calistar_180x5.step]
2024-03-23 Update stl and step to include bottom chamfer
    [calistar_100x2.step, calistar_100x2.stl, calistar_120x2.step, calistar_120x2.stl, calistar_120x3.step, calistar_120x3.stl, calistar_140x4.step, calistar_140x4.stl]
